DanishMalik333/superheat-control/Superheat_Control/Core/Src/main.c

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
/* Includes ------------------------------------------------------------------*/
#include "main.h"
#include "cmsis_os.h"

/* USER CODE BEGIN Includes */
#include "pid.h"
#include "bme280.h"
#include "i2c1_bus.h"
#include "lcd2004.h"
#include "FreeRTOS.h"
#include "task.h"
#include <math.h>
#include <stdio.h>
#include <string.h>
/* USER CODE END Includes */

/* USER CODE BEGIN PD */
#define PID_KP        0.1
#define PID_KI        0.015
#define PID_TS        1.0
#define PID_OUT_MIN   0.1
#define PID_OUT_MAX   0.9

#define LINK_RX_BUF_LEN   32
#define SETPOINT_DEGC     10.0 /* superheat setpoint, degC */
/* USER CODE END PD */

SPI_HandleTypeDef hspi1;

UART_HandleTypeDef huart1;
UART_HandleTypeDef huart2;

/* Definitions for LinkTask */
osThreadId_t LinkTaskHandle;
const osThreadAttr_t LinkTask_attributes = {
  .name = "LinkTask",
  .stack_size = 512 * 4,
  .priority = (osPriority_t) osPriorityAboveNormal,
};
/* Definitions for SensorTask */
osThreadId_t SensorTaskHandle;
const osThreadAttr_t SensorTask_attributes = {
  .name = "SensorTask",
  .stack_size = 256 * 4,
  .priority = (osPriority_t) osPriorityNormal,
};
/* Definitions for ControlTask */
osThreadId_t ControlTaskHandle;
const osThreadAttr_t ControlTask_attributes = {
  .name = "ControlTask",
  .stack_size = 512 * 4,
  .priority = (osPriority_t) osPriorityNormal,
};
/* Definitions for SimTempQueue */
osMessageQueueId_t SimTempQueueHandle;
const osMessageQueueAttr_t SimTempQueue_attributes = {
  .name = "SimTempQueue"
};
/* Definitions for ValveOutputQueue */
osMessageQueueId_t ValveOutputQueueHandle;
const osMessageQueueAttr_t ValveOutputQueue_attributes = {
  .name = "ValveOutputQueue"
};
/* USER CODE BEGIN PV */
static PID_t pid;

/* Interrupt-driven USART1 line reception. HAL_UART_Receive_IT is re-armed for
 * one byte at a time from the RxCpltCallback, so incoming bytes are captured
 * by the peripheral/ISR regardless of what the main loop is doing, avoiding
 * the overrun that polling HAL_UART_Receive suffered from. When a full line is
 * assembled the ISR sends LinkTask a task notification, so LinkTask blocks
 * until the line is ready instead of polling link_rx_line_ready. */
static uint8_t link_rx_byte;
static char link_rx_line[LINK_RX_BUF_LEN];
static volatile uint16_t link_rx_len = 0;
static volatile uint8_t link_rx_line_ready = 0;

/* Latest BME280 ambient reading, written by SensorTask and read by LinkTask
 * (sent to Board 2 as the plant's load disturbance) and ControlTask (logged).
 * Kept as a float rather than a double on purpose: an aligned 32-bit load or
 * store is a single atomic access on the Cortex-M4, so readers can never see
 * a half-written value and no mutex is needed. NAN means "no valid reading"
 * (sensor missing or bus error), in which case Board 2 is sent no ambient. */
static volatile float latest_bme280_degC = NAN;
static int bme280_ok = 0;

/* Latest loop values for the LCD, written by ControlTask and read by
 * DisplayTask. Floats for the same single-access atomicity reason as above. */
static volatile float display_superheat_degC = NAN;
static volatile float display_valve = NAN;

/* DisplayTask is created in the RTOS_THREADS user section rather than through
 * CubeMX, so its definition lives here instead of in the generated block. */
osThreadId_t DisplayTaskHandle;
const osThreadAttr_t DisplayTask_attributes = {
  .name = "DisplayTask",
  .stack_size = 512 * 4, /* snprintf float formatting is stack-heavy */
  .priority = (osPriority_t) osPriorityBelowNormal,
};
/* USER CODE END PV */

void SystemClock_Config(void);
static void MX_GPIO_Init(void);
static void MX_USART2_UART_Init(void);
static void MX_SPI1_Init(void);
static void MX_USART1_UART_Init(void);
void StartLinkTask(void *argument);
void StartSensorTask(void *argument);
void StartControlTask(void *argument);

/* USER CODE BEGIN PFP */
static void StartDisplayTask(void *argument);
/* USER CODE END PFP */

/* USER CODE BEGIN 0 */
void vApplicationStackOverflowHook(TaskHandle_t xTask, char *pcTaskName)
{
  (void)xTask;
  printf("!!! STACK OVERFLOW in task: %s\r\n", pcTaskName);
  __disable_irq();
  for (;;) { }
}

void vApplicationMallocFailedHook(void)
{
  printf("!!! FreeRTOS heap allocation failed (out of heap)\r\n");
  __disable_irq();
  for (;;) { }
}

int __io_putchar(int ch)
{
  HAL_UART_Transmit(&huart2, (uint8_t *)&ch, 1, HAL_MAX_DELAY);
  return ch;
}

/* Called from USART1_IRQHandler via HAL_UART_IRQHandler whenever one byte has
 * been received. Assembles line_rx_line and re-arms the next single-byte
 * receive so bytes are never missed while the main loop is busy elsewhere. */
void HAL_UART_RxCpltCallback(UART_HandleTypeDef *huart)
{
  if (huart->Instance != USART1)
  {
    return;
  }

  uint8_t ch = link_rx_byte;
  BaseType_t higher_priority_woken = pdFALSE;

  if (!link_rx_line_ready)
  {
    if (ch == '\n')
    {
      link_rx_line[link_rx_len] = '\0';
      link_rx_line_ready = 1;

      /* Wake LinkTask. USART1 runs at NVIC priority 5, which is allowed to
       * call FromISR APIs (configMAX_SYSCALL_INTERRUPT_PRIORITY). The guard
       * covers bytes arriving before the scheduler has started. */
      if ((LinkTaskHandle != NULL) &&
          (xTaskGetSchedulerState() != taskSCHEDULER_NOT_STARTED))
      {
        vTaskNotifyGiveFromISR((TaskHandle_t)LinkTaskHandle, &higher_priority_woken);
      }
    }
    else if (ch != '\r')
    {
      if (link_rx_len < LINK_RX_BUF_LEN - 1)
      {
        link_rx_line[link_rx_len++] = (char)ch;
      }
      else
      {
        /* Line too long: drop it and resync on the next '\n'. */
        link_rx_len = 0;
      }
    }
  }

  HAL_UART_Receive_IT(&huart1, &link_rx_byte, 1);

  /* If LinkTask outranks the interrupted task, switch to it on exit. */
  portYIELD_FROM_ISR(higher_priority_woken);
}

/* Blocks (with a 500 ms timeout) until HAL_UART_RxCpltCallback has assembled
 * one "<tick>,<value>\r\n" line from USART1 and notified this task. Returns 1
 * on success. The flag is re-checked after each wake-up, so a stale
 * notification left over from an earlier late reply can't end the wait early. */
static int Link_ReceiveLine(unsigned long *tick, double *value)
{
  uint32_t start = HAL_GetTick();

  while (!link_rx_line_ready)
  {
    uint32_t elapsed = HAL_GetTick() - start;

    if (elapsed >= 500)
    {
      return 0;
    }

    ulTaskNotifyTake(pdTRUE, pdMS_TO_TICKS(500 - elapsed));
  }

  int ok = (link_rx_len > 0) && (sscanf(link_rx_line, "%lu,%lf", tick, value) == 2);

  link_rx_len = 0;
  link_rx_line_ready = 0;

  return ok;
}

/* Sends "<tick>,<valve>,<ambient>\r\n" to Board 2, or "<tick>,<valve>\r\n"
 * when there is no valid ambient reading - Board 2 then holds the last
 * disturbance it received. */
static void Link_SendLine(unsigned long tick, double value, float ambient_degC)
{
  char out[LINK_RX_BUF_LEN];
  int n;

  if (isnan(ambient_degC))
  {
    n = snprintf(out, sizeof(out), "%lu,%.4f\r\n", tick, value);
  }
  else
  {
    n = snprintf(out, sizeof(out), "%lu,%.4f,%.2f\r\n", tick, value, (double)ambient_degC);
  }

  if (n < 0 || n >= (int)sizeof(out))
  {
    return; /* would have been truncated - never send a partial frame */
  }

  HAL_UART_Transmit(&huart1, (uint8_t *)out, (uint16_t)n, 100);
}
/* USER CODE END 0 */

/**
  * @brief  The application entry point.
  * @retval int
  */
int main(void)
{

  /* MCU Configuration--------------------------------------------------------*/

  /* Reset of all peripherals, Initializes the Flash interface and the Systick. */
  HAL_Init();

  /* Configure the system clock */
  SystemClock_Config();

  /* Initialize all configured peripherals */
  MX_GPIO_Init();
  MX_USART2_UART_Init();
  MX_SPI1_Init();
  MX_USART1_UART_Init();
  /* USER CODE BEGIN 2 */
  HAL_UART_Receive_IT(&huart1, &link_rx_byte, 1);

  uint8_t chip_id = 0;
  bme280_ok = (BME280_Init(&bme280_bus, &chip_id) == 0);
  if (bme280_ok)
  {
    printf("# BME280 over %s, chip_id=0x%02X\r\n", bme280_bus.name, chip_id);
  }
  else
  {
    printf("# BME280 over %s not found (chip_id=0x%02X, expect 0x%02X) - running without ambient disturbance\r\n",
           bme280_bus.name, chip_id, BME280_CHIP_ID_VALUE);
  }

  PID_Init(&pid, PID_KP, PID_KI, PID_TS, PID_OUT_MIN, PID_OUT_MAX);

  printf("tick,bme280_degC,plant_degC,valve,setpoint_degC\r\n");
  /* USER CODE END 2 */

  /* Init scheduler */
  osKernelInitialize();

  /* USER CODE BEGIN RTOS_MUTEX */
  /* SensorTask (I2C build) and DisplayTask share I2C1 */
  I2C1_CreateMutex();
  /* USER CODE END RTOS_MUTEX */

  /* USER CODE BEGIN RTOS_SEMAPHORES */
  /* add semaphores, ... */
  /* USER CODE END RTOS_SEMAPHORES */

  /* USER CODE BEGIN RTOS_TIMERS */
  /* start timers, add new ones, ... */
  /* USER CODE END RTOS_TIMERS */

  /* Create the queue(s) */
  /* creation of SimTempQueue */
  SimTempQueueHandle = osMessageQueueNew (1, sizeof(double), &SimTempQueue_attributes);

  /* creation of ValveOutputQueue */
  ValveOutputQueueHandle = osMessageQueueNew (1, sizeof(double), &ValveOutputQueue_attributes);

  /* USER CODE BEGIN RTOS_QUEUES */
  /* add queues, ... */
  /* USER CODE END RTOS_QUEUES */

  /* Create the thread(s) */
  /* creation of LinkTask */
  LinkTaskHandle = osThreadNew(StartLinkTask, NULL, &LinkTask_attributes);

  /* creation of SensorTask */
  SensorTaskHandle = osThreadNew(StartSensorTask, NULL, &SensorTask_attributes);

  /* creation of ControlTask */
  ControlTaskHandle = osThreadNew(StartControlTask, NULL, &ControlTask_attributes);

  /* USER CODE BEGIN RTOS_THREADS */
  DisplayTaskHandle = osThreadNew(StartDisplayTask, NULL, &DisplayTask_attributes);
  /* USER CODE END RTOS_THREADS */

  /* USER CODE BEGIN RTOS_EVENTS */
  /* add events, ... */
  /* USER CODE END RTOS_EVENTS */

  /* Start scheduler */
  osKernelStart();

  /* We should never get here as control is now taken by the scheduler */

  /* Infinite loop */
  /* USER CODE BEGIN WHILE */
  while (1)
  {
    /* USER CODE END WHILE */

    /* USER CODE BEGIN 3 */
  }
  /* USER CODE END 3 */
}

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
/* USER CODE BEGIN 4 */
static void rtos_delay_ms(uint32_t ms)
{
  osDelay(ms); /* configTICK_RATE_HZ is 1000, so ticks == ms */
}

/* One LCD row as a label, a right-aligned value and a unit, e.g.
 * "Superheat   10.2 °C". NaN (no data yet) shows as "--.-". */
static void DisplayRow(uint8_t row, const char *label, float value, const char *unit)
{
  char line[LCD2004_COLS + 1];

  if (isnan(value))
  {
    snprintf(line, sizeof(line), "%-10s  --.- %s", label, unit);
  }
  else
  {
    snprintf(line, sizeof(line), "%-10s%6.1f %s", label, (double)value, unit);
  }
  LCD2004_WriteLine(row, line);
}

/* Shows the live loop state on the 20x4 LCD:
 *   Superheat   10.2 °C
 *   Setpoint    10.0 °C
 *   Valve       50.0 %
 *   Ambient     23.4 °C
 * Lowest-priority task, since the display is for the operator only and must
 * never delay the control or link tasks. */
static void StartDisplayTask(void *argument)
{
  (void)argument;
  /* 0xDF is the degree sign in the HD44780's A00 character ROM. Kept as a
   * separate literal so the hex escape doesn't swallow the 'C'. */
  static const char deg_c[] = "\xDF" "C";

  if (LCD2004_Init(rtos_delay_ms) != 0)
  {
    printf("# LCD not found at I2C address 0x%02X - display disabled\r\n", LCD2004_I2C_ADDR);
    osThreadExit();
  }

  for (;;)
  {
    float valve = display_valve;

    DisplayRow(0, "Superheat", display_superheat_degC, deg_c);
    DisplayRow(1, "Setpoint", (float)SETPOINT_DEGC, deg_c);
    DisplayRow(2, "Valve", isnan(valve) ? valve : valve * 100.0f, "%");
    DisplayRow(3, "Ambient", latest_bme280_degC, deg_c);

    osDelay(500);
  }
}
/* USER CODE END 4 */

/* USER CODE BEGIN Header_StartLinkTask */
/**
  * @brief  Function implementing the LinkTask thread.
  * @param  argument: Not used
  * @retval None
  */
/* USER CODE END Header_StartLinkTask */
void StartLinkTask(void *argument)
{
  /* USER CODE BEGIN 5 */
  unsigned long tick = 0;
  double valve_output = PID_OUT_MIN;

  for(;;)
  {
    /* Pick up the latest valve output computed by ControlTask, if any new
     * one is available; otherwise keep sending the last known value. */
    osMessageQueueGet(ValveOutputQueueHandle, &valve_output, NULL, 0);

    unsigned long echoed_tick = 0;
    double received_temp = 0.0;

    Link_SendLine(tick, valve_output, latest_bme280_degC);

    if (Link_ReceiveLine(&echoed_tick, &received_temp))
    {
      osMessageQueueReset(SimTempQueueHandle);
      osMessageQueuePut(SimTempQueueHandle, &received_temp, 0, 0);
    }
    else
    {
      printf("# HIL link: malformed/missing frame, holding last simulated_temp\r\n");
    }

    tick++;
    osDelay(1000);
  }
  /* USER CODE END 5 */
}

/* USER CODE BEGIN Header_StartSensorTask */
/**
* @brief Function implementing the SensorTask thread.
* @param argument: Not used
* @retval None
*/
/* USER CODE END Header_StartSensorTask */
void StartSensorTask(void *argument)
{
  /* USER CODE BEGIN StartSensorTask */
  for(;;)
  {
    if (!bme280_ok)
    {
      osDelay(1000); /* no sensor found at startup - nothing to sample */
      continue;
    }

    /* Forced mode powers down after one measurement; re-trigger each cycle */
    double temp_degC = 0.0;
    int ok = (BME280_TriggerMeasurement() == 0);
    osDelay(BME280_MEAS_TIME_MS); /* allow conversion to complete */

    if (ok && BME280_ReadTemperature(&temp_degC) == 0)
    {
      latest_bme280_degC = (float)temp_degC;
    }
    else
    {
      /* A bus error invalidates the reading rather than freezing the last
       * value, so Board 2 stops being fed a stale disturbance. */
      latest_bme280_degC = NAN;
    }

    osDelay(1000 - BME280_MEAS_TIME_MS); /* sample once per second overall */
  }
  /* USER CODE END StartSensorTask */
}

/* USER CODE BEGIN Header_StartControlTask */
/**
* @brief Function implementing the ControlTask thread.
* @param argument: Not used
* @retval None
*/
/* USER CODE END Header_StartControlTask */
void StartControlTask(void *argument)
{
  /* USER CODE BEGIN StartControlTask */
  unsigned long tick = 0;
  double simulated_temp = 0.0;

  for(;;)
  {
    /* Use the latest simulated temp from LinkTask if a new one arrived
     * since last cycle; otherwise hold the previous value. */
    osMessageQueueGet(SimTempQueueHandle, &simulated_temp, NULL, 0);

    double valve_output = PID_Update(&pid, SETPOINT_DEGC, simulated_temp);

    osMessageQueueReset(ValveOutputQueueHandle);
    osMessageQueuePut(ValveOutputQueueHandle, &valve_output, 0, 0);

    display_superheat_degC = (float)simulated_temp;
    display_valve = (float)valve_output;

    printf("%lu,%.2f,%.4f,%.3f,%.2f\r\n",
           tick, (double)latest_bme280_degC, simulated_temp, valve_output, SETPOINT_DEGC);

    tick++;
    osDelay(1000);
  }
  /* USER CODE END StartControlTask */
}

/**
  * @brief  This function is executed in case of error occurrence.
  * @retval None
  */
void Error_Handler(void)
{
  /* USER CODE BEGIN Error_Handler_Debug */
  /* User can add his own implementation to report the HAL error return state */
  __disable_irq();
  while (1)
  {
  }
  /* USER CODE END Error_Handler_Debug */
}
#ifdef USE_FULL_ASSERT
/**
  * @brief  Reports the name of the source file and the source line number
  *         where the assert_param error has occurred.
  * @param  file: pointer to the source file name
  * @param  line: assert_param error line source number
  * @retval None
  */
void assert_failed(uint8_t *file, uint32_t line)
{
  /* USER CODE BEGIN 6 */
  /* User can add his own implementation to report the file name and line number,
     ex: printf("Wrong parameters value: file %s on line %d\r\n", file, line) */
  /* USER CODE END 6 */
}
#endif /* USE_FULL_ASSERT */
