DanishMalik333/superheat-control/(commit log)

2026-09-26 Initial commit: combine Superheat_Control and HVACPlant into one repo
    Restructures the two-board HIL project so both the Controller
    (Superheat_Control) and Plant Simulator (HVACPlant) firmware live under
    one shared repo root, sharing a single .gitignore, for tracking both
    boards together going forward.
2026-09-26 Wire USART1 inter-board link on Board 1, switch HVACPlant to CMake, add TX/RX diagnostics
    - Board 1 (Superheat_Control): added USART1 (PA9/PA10) init and MSP config
    by hand for the inter-board link, plus Link_SendLine/Link_ReceiveLine
    helpers matching HVACPlant's protocol; PID now driven by the plant's
    simulated temperature instead of the raw BME280 reading.
    - HVACPlant regenerated for the CMake/GCC toolchain instead of EWARM/IAR,
    removing the now-unused EWARM project files.
    - Re-discretized plant.h coefficients (PLANT_NUM/PLANT_DEN) for Ts=1s,
    matching the Simulink-side re-tuning.
    - Dropped the invalid -u _scanf_float linker flag (not a valid symbol on
    this toolchain) from both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
2026-09-26 Fix newlib-nano scanf float linker flag and clean up debug printfs
    CMake/Ninja was mangling two separate -u SYMBOL target_link_options
    entries into a single -u flag followed by both symbol names, causing
    ld to treat _scanf_float as a missing file. Switched to the atomic
    -Wl,-u,SYMBOL form for both _printf_float and _scanf_float in both
    projects. This was causing every received UART frame to be misparsed
    as malformed, deadlocking the HIL link. Also removed the TX/RX status
    diagnostic printfs added during debugging.
    [main.c]
2026-09-26 Switch inter-board UART reception to interrupt-driven line assembly
    Polling HAL_UART_Receive byte-by-byte only protects the single-byte
    RDR if the CPU is inside the polling call at the exact moment a byte
    arrives. Any time the CPU was elsewhere (printf, plant update), an
    incoming byte could be silently overwritten by the next one before
    being read, corrupting that frame. Both boards now arm
    HAL_UART_Receive_IT once at startup and assemble each line inside
    HAL_UART_RxCpltCallback, which the UART interrupt guarantees runs the
    instant a byte arrives regardless of main loop state. Link_ReceiveLine
    now just waits on a line-ready flag instead of touching bytes
    directly. NVIC USART1 interrupt enabl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
2026-09-26 Add README, step response figure, and live plotting/logging tools
    tools/plot_live.py reads Board 1's debug UART, live-plots plant
    temperature vs. setpoint and valve output, and logs every row to a
    timestamped CSV. tools/plot_from_log.py regenerates a static plot from
    a saved log. README documents the two-board HIL architecture, control
    loop, wiring, and the interrupt-driven UART fix.
    [plot_from_log.py, plot_live.py]
2026-09-26 Regenerate HVACPlant with STM32CubeMX 6.18.1
    Upgraded CubeMX (was 6.12.0, .ioc required 6.18.1+) and regenerated to
    unblock further .ioc editing. Restructures the CMake project to the
    newer CubeMX layout (separate STM32_Drivers object library) and now
    natively generates the USART1 NVIC interrupt setup from the .ioc.
    Restored includes (plant.h, stdio.h, string.h) that were outside the
    USER CODE guard and got dropped on regeneration, and removed the
    resulting duplicate NVIC setup/enable calls in stm32f4xx_hal_msp.c.
2026-09-26 Split Board 1 control loop into FreeRTOS tasks
    Enabled FreeRTOS (CMSIS-RTOS v2) via CubeMX and split the previous
    sequential superloop into three tasks: SensorTask (BME280 read),
    LinkTask (UART exchange with Board 2), and ControlTask (PID update and
    debug logging), connected via SimTempQueue and ValveOutputQueue.
    Two issues surfaced getting this running:
    - HAL_MspInit never called HAL_NVIC_SetPriorityGrouping(NVIC_PRIORITYGROUP_4).
    FreeRTOS's Cortex-M port assumes 4 preemption-priority bits; running on
    the reset default silently broke interrupt masking and produced zero
    serial output with no error.
    - LinkTask overflowed its stack. sscanf/snprintf float formatting in
    newlib-nano need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
    [Superheat_Control.ioc, main.c]
2026-09-26 Label plots as superheat/percent, add architecture diagrams to README
    Valve output is now shown as a 0-100% opening instead of the raw 0-1
    value, and both plotting scripts label the plant/setpoint series as
    superheat rather than generic temperature, matching what the
    discretized plant model actually represents. Fixed a stale comment on
    SETPOINT_DEGC that called it a placeholder when it has been a
    superheat setpoint all along.
    Added Mermaid diagrams to the README: one showing the two-board HIL
    data flow, one showing Board 1's FreeRTOS task/queue structure.
    Replaced the step response figure and caption with a fresh capture
    using the updated plot labels.
    [main.c, plot_from_log.py, plot_live.py]
2026-09-27 Feed BME280 ambient into plant as disturbance, add I2C option and LCD
    The BME280 reading is no longer logged only. Board 1 now sends it to
    Board 2 with each frame ("<tick>,<valve>,<ambient>"), and the plant
    model adds the deviation from 22 C as a load disturbance through the
    same first-order lag as the valve (Kd = 0.5 C superheat per C ambient).
    The controller only sees its effect on superheat, so warming the sensor
    by hand produces a real disturbance the PI loop has to reject. If the
    sensor is missing or a read fails, the ambient field is omitted and
    Board 2 holds the last value.
    Moved the BME280 code out of main.c into bme280.c behind a small
    register-level bus interface, with SPI and I2C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
    [bme280.c, bme280.h, bme280_bus_i2c.c, bme280_bus_spi.c, i2c1_bus.c, i2c1_bus.h, lcd1602.c, lcd1602.h]
2026-09-27 Switch operator display from 16x2 to 20x4 LCD
    The panel actually fitted is a 2004A with the same PCF8574 I2C backpack,
    so the driver keeps its I2C/4-bit protocol and only changes geometry:
    renamed lcd1602 to lcd2004, 20 columns by 4 rows, with row starts at
    DDRAM 0x00/0x40/0x14/0x54 since a 20x4 is two 40-char HD44780 lines
    split in half.
    DisplayTask now shows one value per row (superheat, setpoint, valve,
    ambient) with a right-aligned value and the ROM degree sign, and shows
    --.- for anything not yet available instead of a misleading 0.
    Built SPI and I2C variants of Board 1 cleanly; not yet tested on
    hardware.
